dasanchez/dualnunchuk_usb/README.md

## dualnunchuk_usb

# A Dual Nunchuk to USB Converter

This repo contains all the project files I generated while I was working on this.

See the video velow for a demo:

Demo Thumbnail (https://www.youtube.com/watch?v=wJ1pXnbddeA)
