dasanchez/dualnunchuk_usb/03 - Hardware - Electronics/nunchuckUSB-v13.pdf

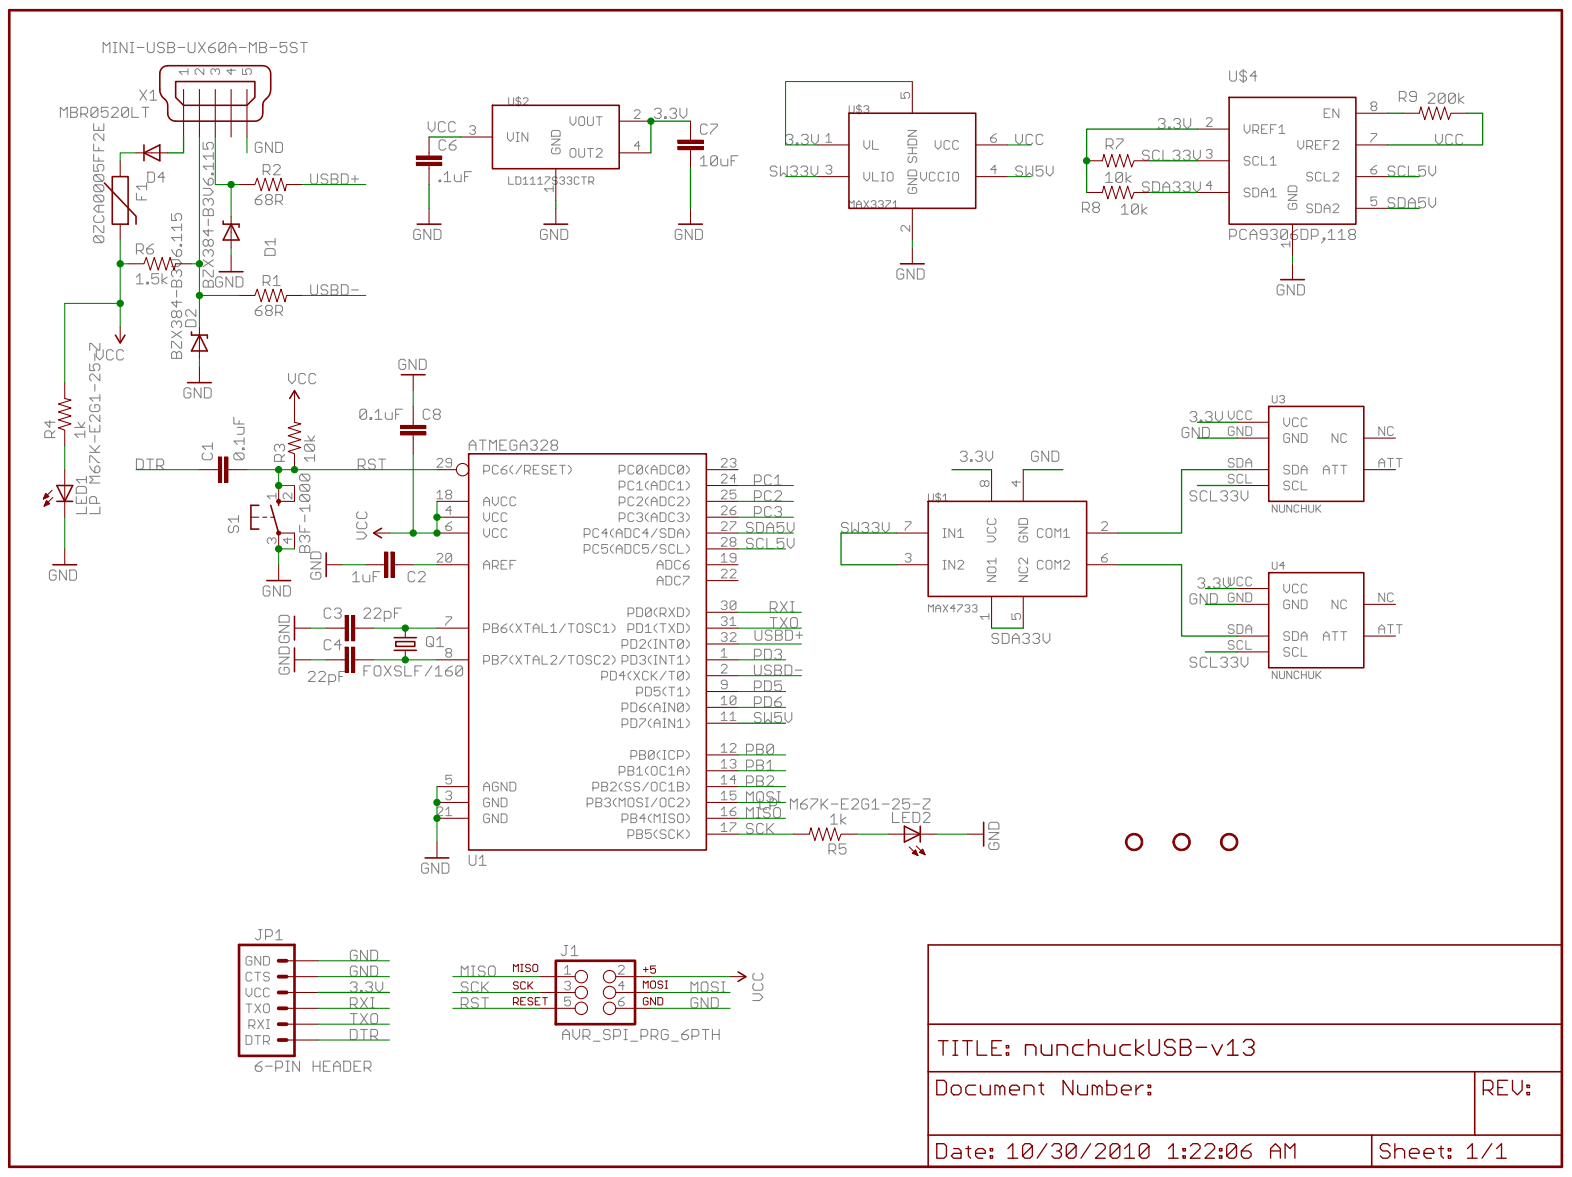
[picture p7: page 1]
