dasanchez/dualnunchuk_usb/02 - Hardware - Housing/HousingBottom.pdf

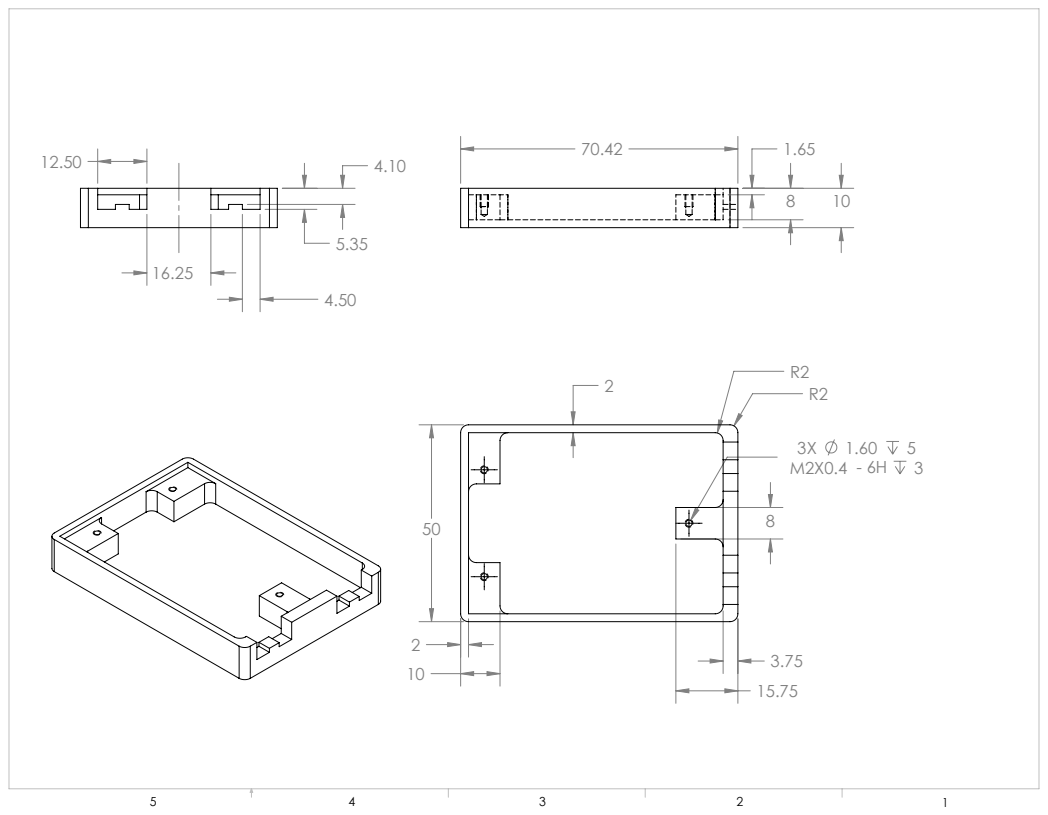
[picture p8: page 1]
