dasanchez/dualnunchuk_usb/02 - Hardware - Housing/HousingTop.pdf

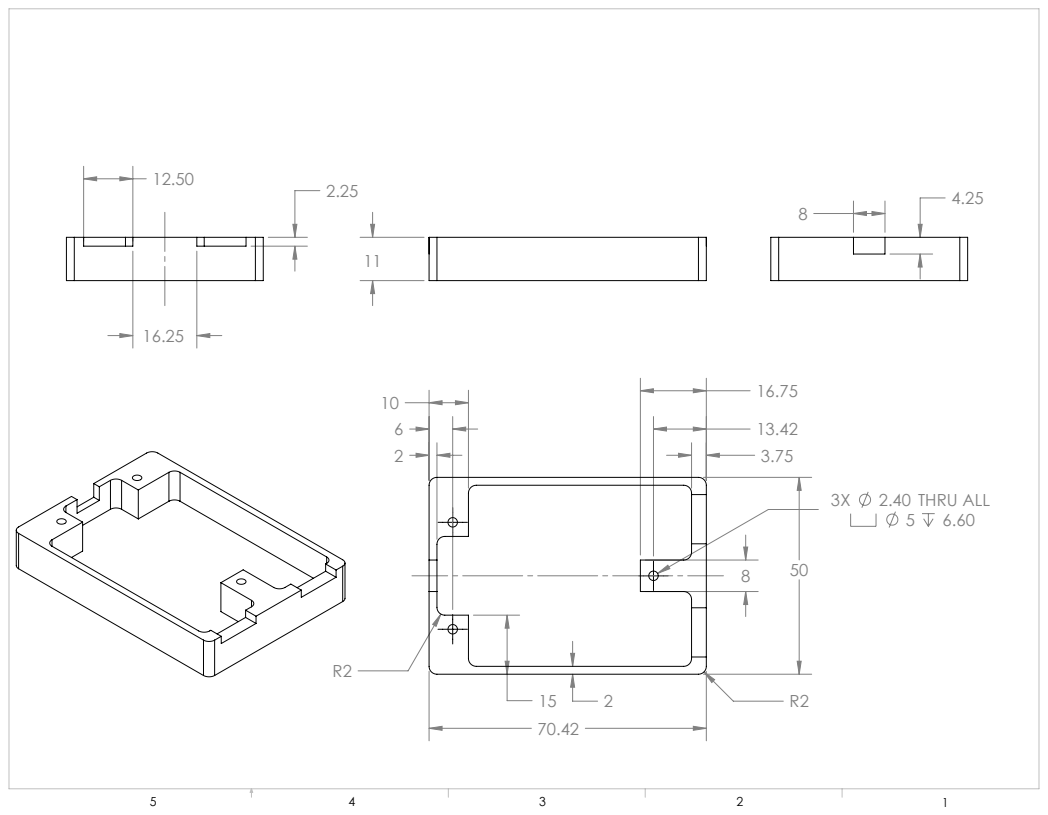
[picture p9: page 1]
2.40 THRU ALL
