dasanchez/dualnunchuk_usb/02 - Hardware - Housing/NunchukUSBPCB.pdf

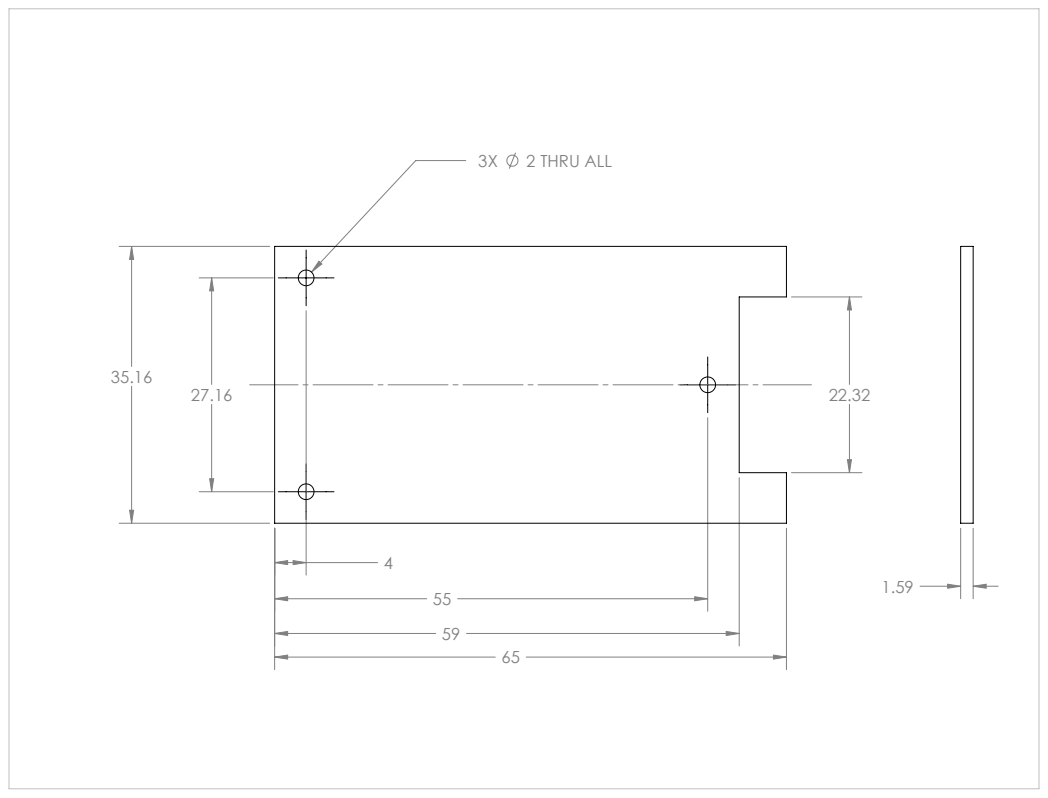
[picture p10: page 1]
2 THRU ALL
