dasanchez/dualnunchuk_usb/(commit log)

2017-10-26 Housing Section
2017-10-26 Electronics Section
    [nunchuckUSB-v13.brd, nunchuckUSB-v13.sch]
